NeusAap/KiCad7SymbolsAndFootprints/PartLibraries/Downloaded/Connectors/3pinsJST_Top/B3B-XH-A_LF__SN_.step

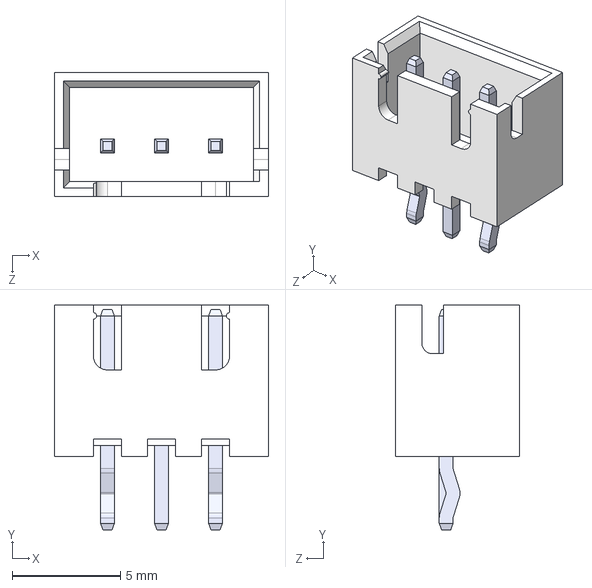
[picture p1: CAD file, 2023-07-13]
PartLibraries/Downloaded/Connectors/3pinsJST_Top/B3B-XH-A_LF__SN_.step
9.90 x 10.4 x 5.75 mm
