NeusAap/KiCad7SymbolsAndFootprints/PartLibraries/Downloaded/Connectors/BM03B-SRSS-TB/eec.models/JST_-_BM03B-SRSS-TB(LF)(SN).step

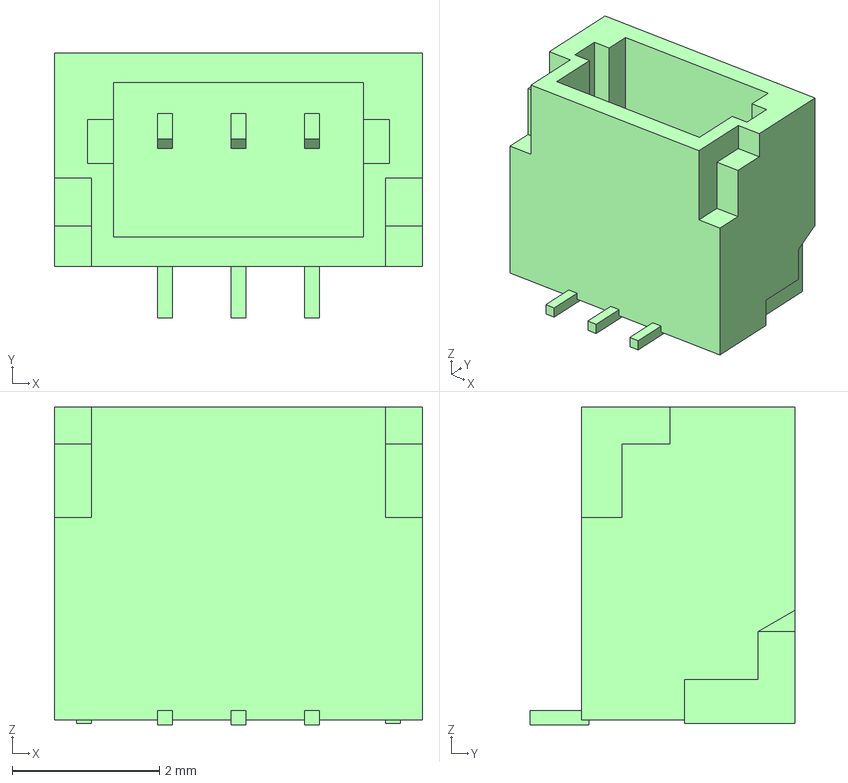
[picture p2: CAD file, 2023-07-13]
PartLibraries/Downloaded/Connectors/BM03B-SRSS-TB/eec.models/JST_-_BM03B-SRSS-TB(LF)(SN).step
5.00 x 3.60 x 4.32 mm
