NeusAap/KiCad7SymbolsAndFootprints/PartLibraries/Downloaded/Connectors/USB4120-03-C/USB4120-03-C_REVA.step

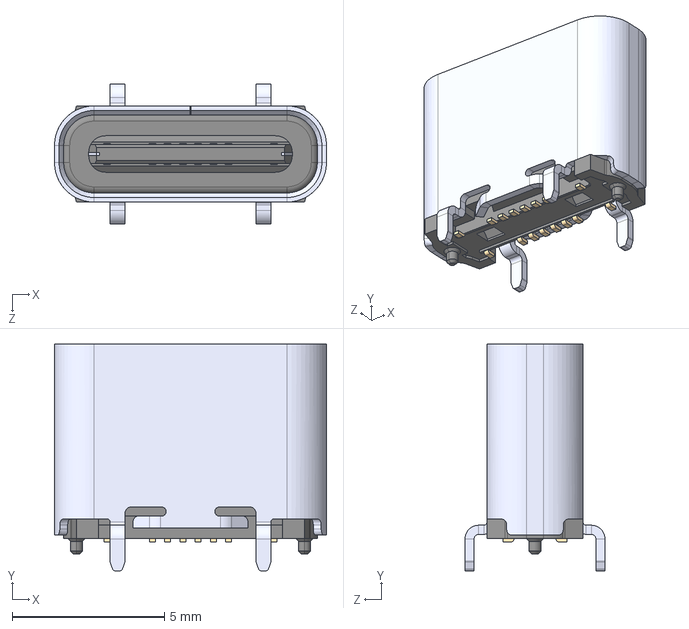
[picture p3: CAD file, 2023-07-15]
PartLibraries/Downloaded/Connectors/USB4120-03-C/USB4120-03-C_REVA.step
8.94 x 7.45 x 4.60 mm
