NeusAap/KiCad7SymbolsAndFootprints/PartLibraries/Downloaded/ICs/TP4056-42-ESOP8/3D/TP4056-42-ESOP8.stp

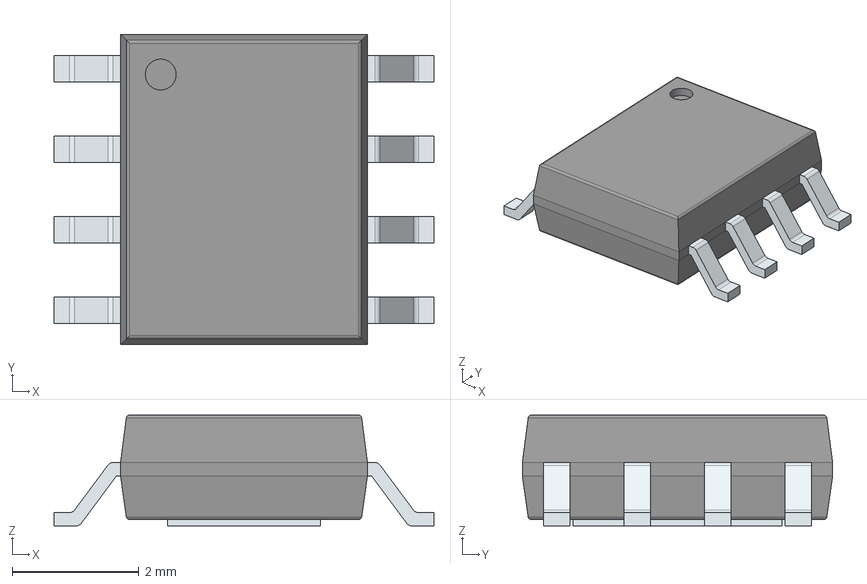
[picture p4: CAD file, 2023-07-13]
PartLibraries/Downloaded/ICs/TP4056-42-ESOP8/3D/TP4056-42-ESOP8.stp
6.00 x 4.90 x 1.75 mm
PinsArrayLR
ThermalPad
