NeusAap/KiCad7SymbolsAndFootprints/PartLibraries/Downloaded/MCUs/STM32WB55CGU6/3D/STM32WB55CGU6.stp

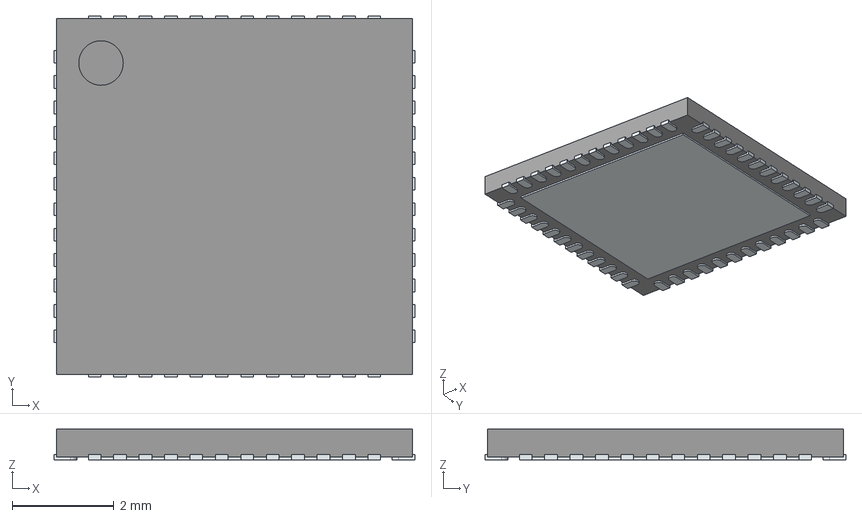
[picture p5: CAD file, 2023-07-13]
PartLibraries/Downloaded/MCUs/STM32WB55CGU6/3D/STM32WB55CGU6.stp
7.10 x 7.10 x 0.6 mm
ThermalPin
PinsArrayLR
PinsArrayTB
