NeusAap/KiCad7SymbolsAndFootprints/(commit log)

2023-07-13 Init with local files
    [B3B-XH-A_LF__SN_.step, JST_-_BM03B-SRSS-TB(LF)(SN).step, STM32WB55CGU6.stp, TP4056-42-ESOP8.stp]
2023-07-15 Added USB-C footprint & symbol Added 2x10 fem/male headers
    [USB4120-03-C_REVA.step]
2023-07-15 Update GCT_USB4120-03-C_REVA_With3DModel.kicad_mod
    To have pin designation on silkscreen
2023-07-16 Added new parts:
    1. Default SMD switch, with an upwards slider (only added 3d model)
    2. Added 3d Model for TPS630000 voltage regulator
    3. Added sideways SMD JST 3 pin p=1mm connector
    4. Added 3D model for 9x9mm flat buzzer
    5. Added latching push button
    6. Added upright SMD JST 3 pin p=1mm connector
2023-09-13 Fixed buzzer footprint
2023-09-25 Added JST footprints
    6 pin connectors
2023-09-27 Updated footprint to bind to fill areas
2023-10-24 Edited regulator silkscreen and added TLC chip
